shonha/EGR314SSH.github.io/docs/index.md

---
title: Welcome
---
## Brief Introduction
Hello, My name is Shon and this is my individual website for the stepper motor subsystem. I use SPI to communicate over a daisy chain network to recieve and send values over UART. My system has four main components: The Stepper Motor, Motor Driver, PIC Microcontroller, and the 3.3V Switching Regulator. The goal of the motor subsystem is to rotate the solar panel based off the message it recieves from the daisy chain network. In return, it will rotate the solar panel based on the direction of the sun so the panel can produce energy at its peak.

## Milestones
|Assignments|Dates|
|---|---|
|Block Diagram| 1/31|
|Component Selection & PIC Table|2/7|
|Schematic Design|2/21|
|Power Budget|2/21|
|External Design Review|2/24|
|BOM & Hardware Orders|2/28|
|Individual API Documentation|3/28|
|Subsystem PCB Design|4/4|
|Subsystem Hardware Verification|4/11|
|Software Implementation|4/23|
|Innovation Showcase|5/2|

[Team Website](https://egr314-2025-s-311.github.io/T311.github.io/)
