shonha/EGR314SSH.github.io/docs/componentschematic.md

---
title: Subsystem Schematic
---

Things to discuss
