shonha/EGR314SSH.github.io/docs/Resources.md

---
title: Resources
---

[Motor Subsystem MPLABX](https://github.com/shonha/EGR314SSH.github.io/blob/main/MPLAB/Team%20Verification.X.zip)

[Team Solar Tracker DXF Cutout](https://github.com/shonha/EGR314SSH.github.io/blob/main/MPLAB/EGR314_SolarTracka.dxf)
