shonha/EGR314SSH.github.io/images/314 BD V2.png

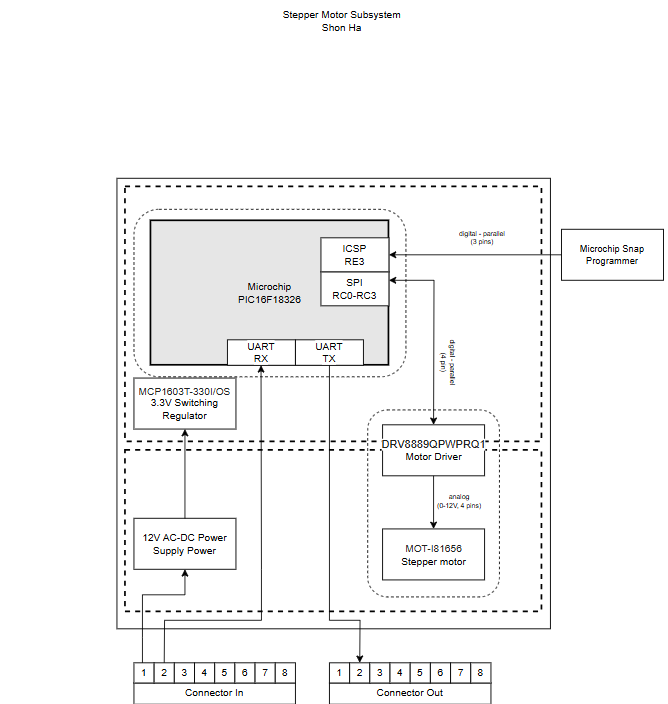
images/314 BD V2.png
