shonha/EGR314SSH.github.io/images/314 Motor Block DiagramV3.png

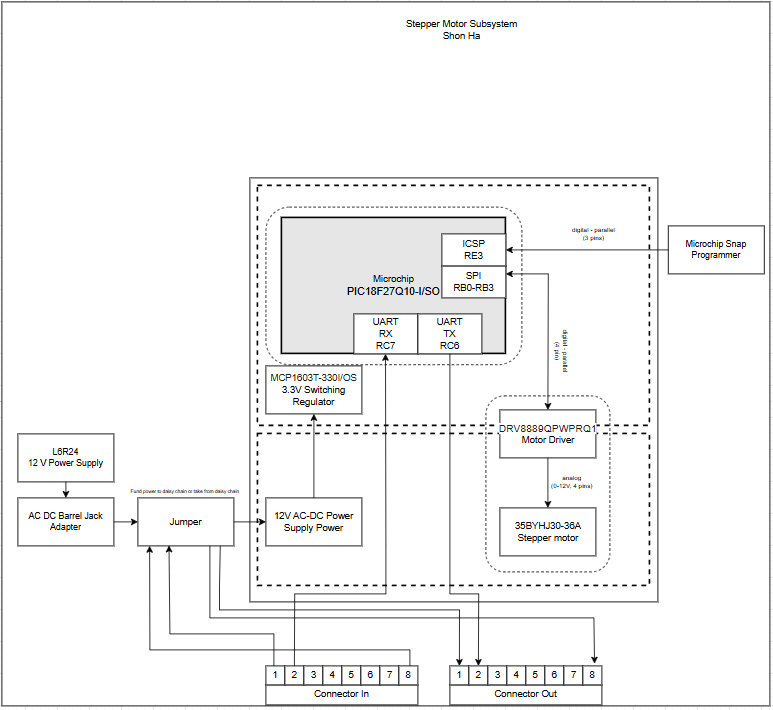
images/314 Motor Block DiagramV3.png
