shonha/EGR314SSH.github.io/images/BOMV2.png

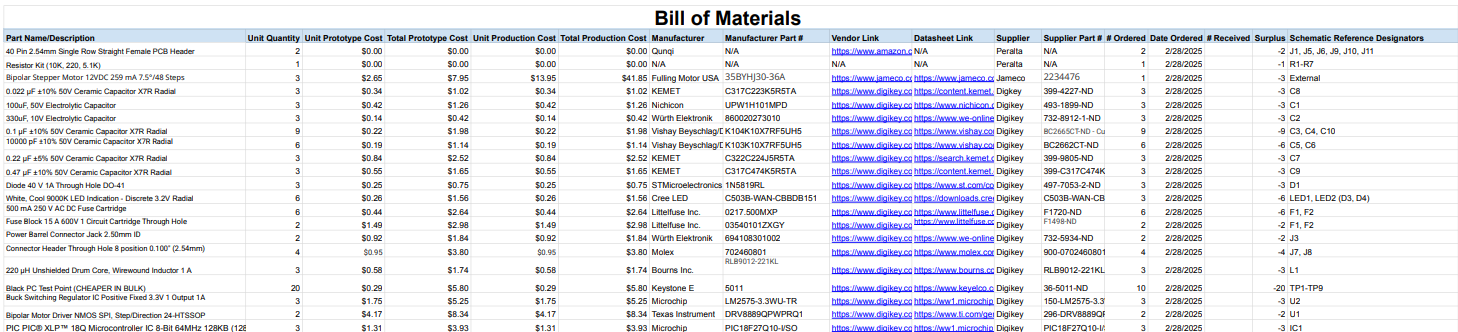
images/BOMV2.png
