shonha/EGR314SSH.github.io/images/cheapmotor.png

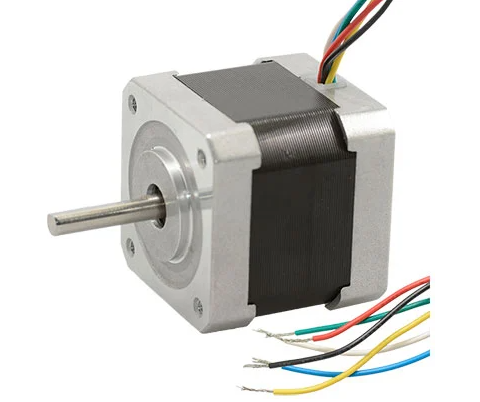
images/cheapmotor.png
