shonha/EGR314SSH.github.io/images/FINALPICLAY.png

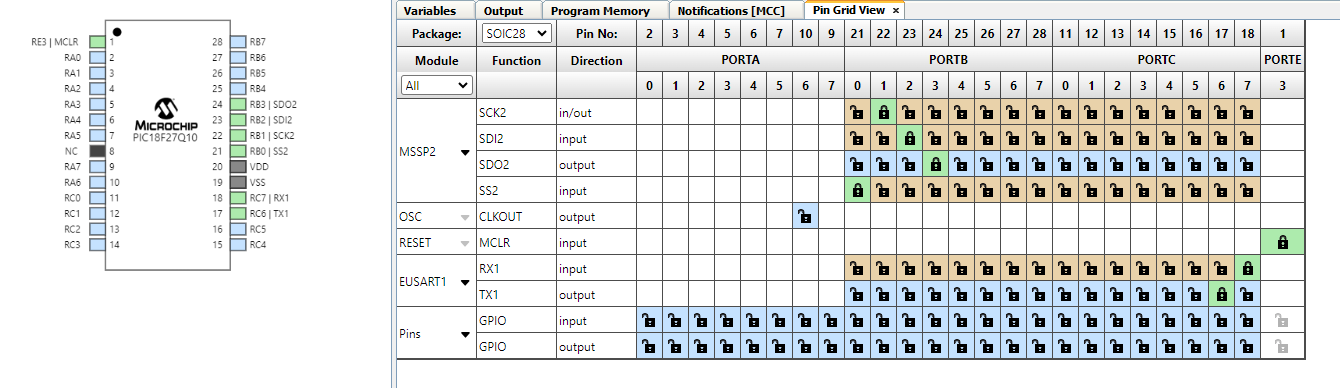
images/FINALPICLAY.png
