shonha/EGR314SSH.github.io/images/MCC CONFIG.png

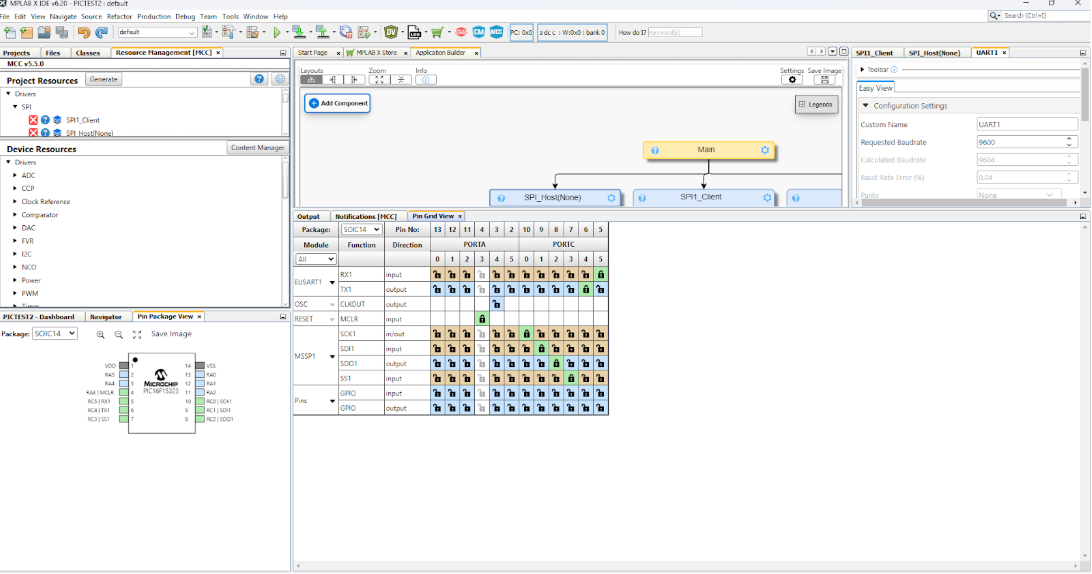
images/MCC CONFIG.png
