shonha/EGR314SSH.github.io/images/PICOPTION3.jpg

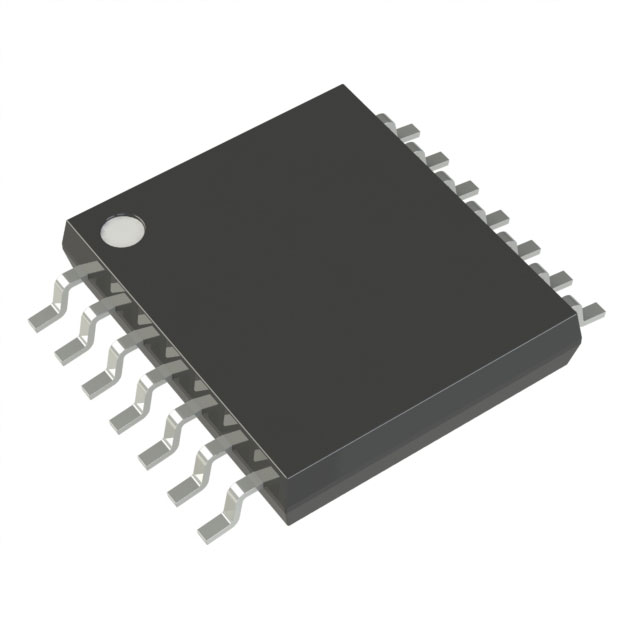
images/PICOPTION3.jpg
