shonha/EGR314SSH.github.io/images/PSOP3.jpg

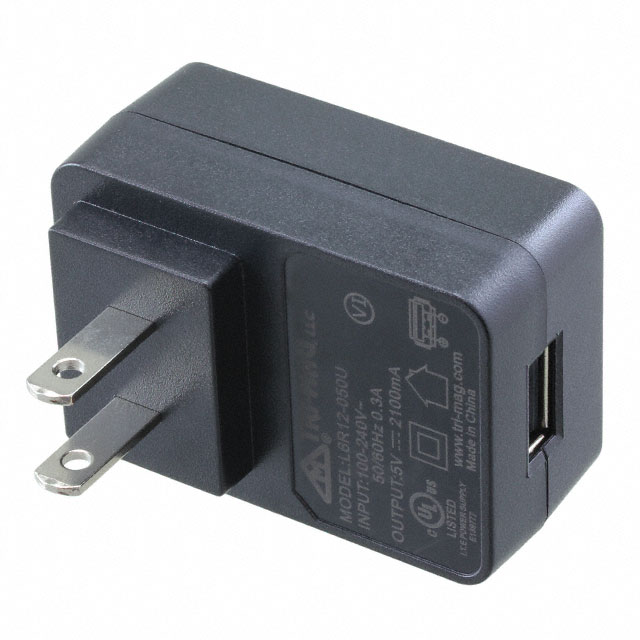
images/PSOP3.jpg
