shonha/EGR314SSH.github.io/images/Screenshot 2025-02-07 162354.png

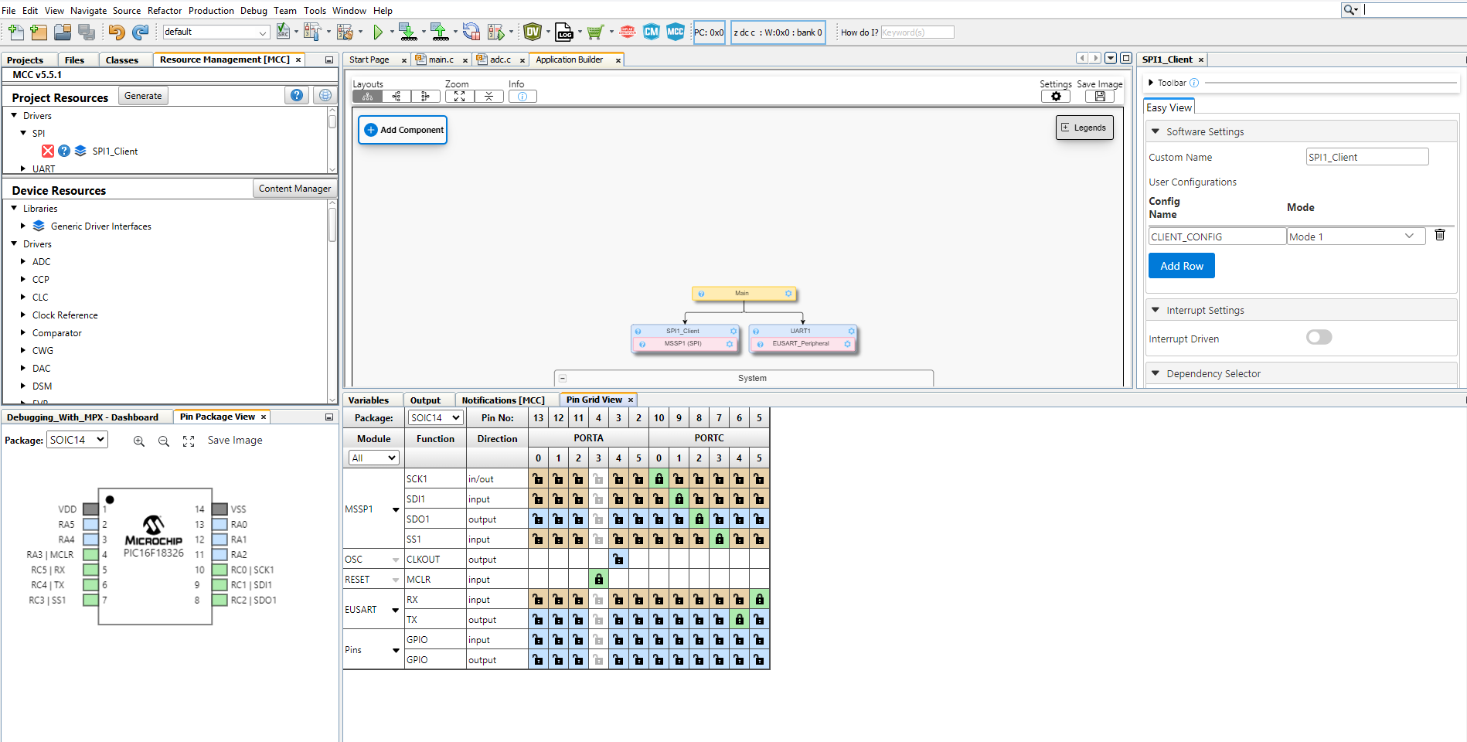
images/Screenshot 2025-02-07 162354.png
