shonha/EGR314SSH.github.io/images/SM4POSS.png

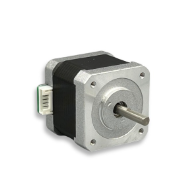
images/SM4POSS.png
