shonha/EGR314SSH.github.io/images/SMOP1.jpg

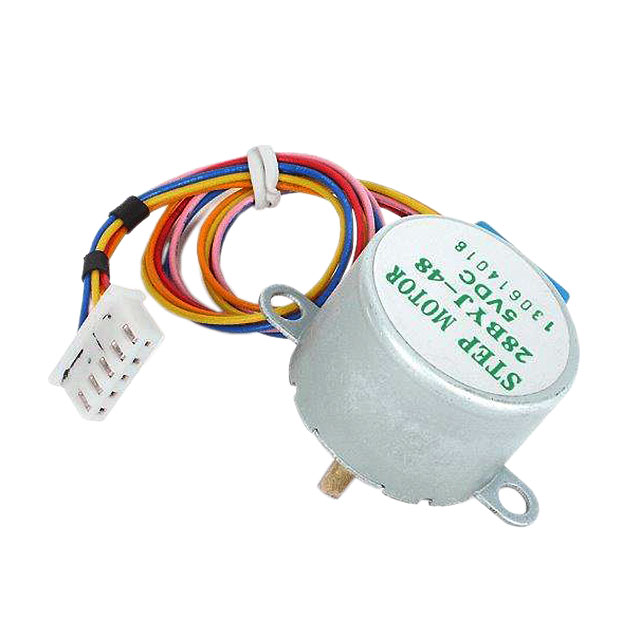
images/SMOP1.jpg
