shonha/EGR314SSH.github.io/images/SUBSYSTEM SCHEMATIC.png

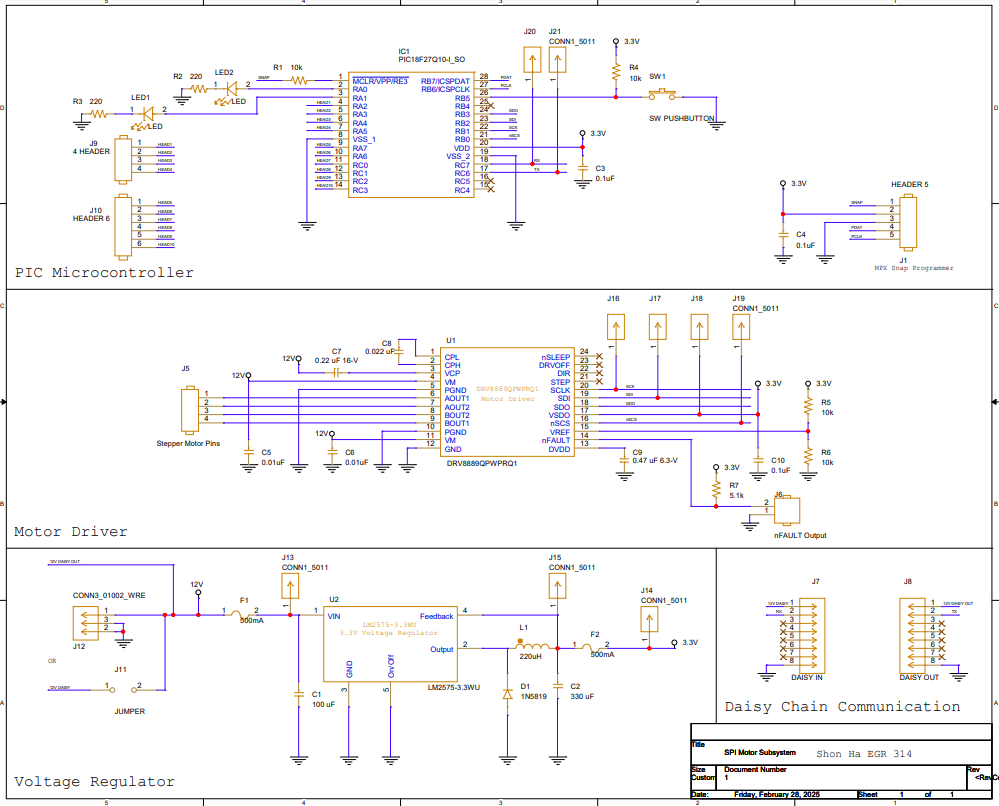
images/SUBSYSTEM SCHEMATIC.png
