shonha/EGR314SSH.github.io/images/Team Block Diagram-Page-3.drawio.png

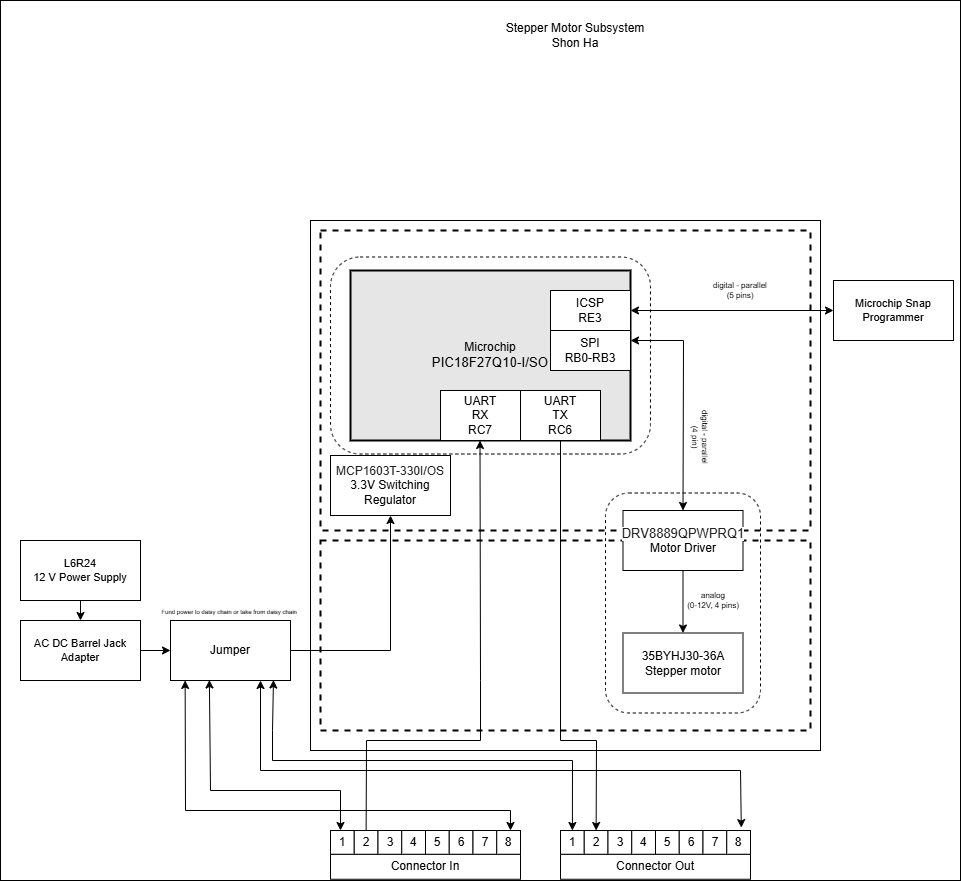
images/Team Block Diagram-Page-3.drawio.png
