shonha/EGR314SSH.github.io/images/VROP3.jpg

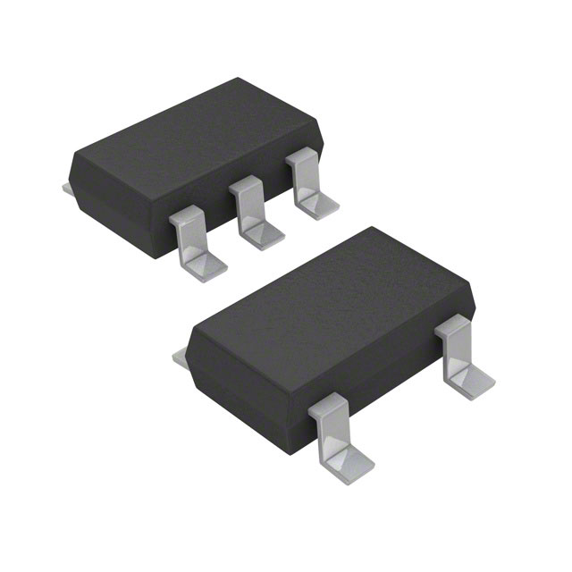
images/VROP3.jpg
