shonha/EGR314SSH.github.io/Documentation/EGR314 BOM.xlsx

Bill of Materials
Part Name/Description | Unit Quantity | Unit Prototype Cost | Total Prototype Cost | Unit Production Cost | Total Production Cost | Manufacturer | Manufacturer Part # | Vendor Link | Datasheet Link | Supplier | Supplier Part # | # Ordered | Date Ordered | # Received | Surplus | Schematic Reference Designators
40 Pin 2.54mm Single Row Straight Female PCB Header | 2 | $0.00 | $0.00 | $0.00 | $0.00 | Qunqi | N/A | https://www.amazon.com/Qunqi-2-54mm-Straight-Connector-Arduino/dp/B07CGGSDWF | N/A | Peralta | N/A | 2 | 2025-02-28 |  | -2 | J1, J5, J6, J9, J10, J11
Resistor Kit (10K, 220, 5.1K) | 1 | $0.00 | $0.00 | $0.00 | $0.00 | N/A | N/A | N/A | N/A | Peralta | N/A | 1 | 2025-02-28 |  | -1 | R1-R7
Bipolar Stepper Motor 12VDC 259 mA 7.5°/48 Steps | 3 | $2.65 | $7.95 | $13.95 | $41.85 | Fulling Motor USA | 35BYHJ30-36A | https://www.jameco.com/z/35BYHJ30-36A-Fulling-Motor-USA-Bipolar-Stepper-Motor-12VDC-259-mA-7-5-deg-48-Steps_2234476.html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 | https://www.jameco.com/Jameco/Products/ProdDS/2234476.pdf | Jameco | 2234476 | 1 | 2025-02-28 |  | -3 | External
CAP CER 0.022UF 50V C0G/NP0 0805 | 3 | $0.56 | $1.68 | $0.56 | $1.68 | KEMET | GCM21B5C1H223JA16L | https://www.digikey.com/en/products/detail/murata-electronics/GCM21B5C1H223JA16L/2039045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 | https://search.murata.co.jp/Ceramy/image/img/A01X/G101/ENG/GCJ188R71H104KA12-02B.pdf | Digkey | 490-5318-2-ND | 3 | 2025-02-28 |  | -3 | C8
100uF, 50V Electrolytic Capacitor | 3 | $0.71 | $2.13 | $0.71 | $2.13 | Nichicon | UUD1H101MNL1GS | https://www.digikey.com/en/products/detail/nichicon/UPW1H101MPD/589640?gclsrc=aw.ds&gad_source=1&gclsrc=aw.ds | https://www.nichicon.co.jp/english/series_items/catalog_pdf/e-uud.pdf | Digikey | 493-2306-2-ND | 3 | 2025-02-28 |  | -3 | C1
330uF, 10V Electrolytic Capacitor | 3 | $0.08 | $0.24 | $0.08 | $0.24 | Nichicon | UUD1A331MNL1GS | https://www.digikey.com/en/products/detail/w%C3%BCrth-elektronik/860020273010/5727147 | https://www.nichicon.co.jp/english/series_items/catalog_pdf/e-uud.pdf | Digikey | 493-2251-2-ND | 3 | 2025-02-28 |  | -3 | C2
0.1 µF ±10% 50V Ceramic Capacitor X7R Radial | 9 | $0.08 | $0.72 | $0.08 | $0.72 | YAGEO | CC0805KRX7R9BB104 | https://www.digikey.com/en/products/detail/yageo/CC0805KRX7R9BB104/302874 | https://www.yageo.com/upload/media/product/productsearch/datasheet/mlcc/UPY-GPHC_X7R_6.3V-to-250V_24.pdf | Digikey | 311-1140-2-ND | 9 | 2025-02-28 |  | -9 | C3, C4, C10
10000 pF ±10% 50V Ceramic Capacitor X7R Radial | 6 | $0.08 | $0.48 | $0.08 | $0.48 | KEMET | C0805C103K5RACTU | https://www.digikey.com/en/products/detail/kemet/C0805C103K5RACTU/411157 | https://search.kemet.com/download/datasheet/C0805C103K5RAC7800 | Digikey | 399-C0805C103K5RACTUTR-ND | 6 | 2025-02-28 |  | -6 | C5, C6
0.22 µF ±5% 50V Ceramic Capacitor X7R Radial | 3 | $0.10 | $0.30 | $0.10 | $0.30 | KEMET | C0805C224K5RACTU | https://www.digikey.com/en/products/detail/kemet/C0805C224K5RACTU/754753 | https://search.kemet.com/download/datasheet/C0805C224K5RAC7800 | Digikey | 399-C0805C224K5RACTUTR-ND | 3 | 2025-02-28 |  | -3 | C7
0.47 µF ±10% 50V Ceramic Capacitor X7R Radial | 3 | $0.22 | $0.66 | $0.22 | $0.66 | Murata Electronics | GRM21BR71H474KA88L | https://www.digikey.com/en/products/detail/murata-electronics/GRM21BR71H474KA88L/702592 | https://search.murata.co.jp/Ceramy/image/img/A01X/G101/ENG/GRM21BR71H474KA88-01.pdf | Digikey | 490-3328-2-ND | 3 | 2025-02-28 |  | -3 | C9
Diode 40 V 1A Through Hole DO-41 | 3 | $0.30 | $0.90 | $0.30 | $0.90 | Diodes Incorporated | 1N5819HWQ-7-F | https://www.digikey.com/en/products/detail/diodes-incorporated/1N5819HWQ-7-F/10294862 | https://www.diodes.com/assets/Datasheets/1N5819HWQ.pdf | Digikey | 31-1N5819HWQ-7-FTR-ND | 3 | 2025-02-28 |  | -3 | D1
White, Cool 9000K LED Indication - Discrete 3.2V Radial | 6 | $0.26 | $1.56 | $0.26 | $1.56 | Cree LED | C503B-WAN-CBBDB151 | https://www.digikey.com/en/products/detail/cree-led/C503B-WAN-CBBDB151/5824241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 | https://downloads.cree-led.com/files/ds/h/HB-C503B-WAN.pdf | Digikey | C503B-WAN-CBBDB151-ND | 3 | 2025-02-28 |  | -6 | LED1, LED2 (D3, D4)
500 mA 250 V AC DC Fuse Cartridge | 6 | $0.44 | $2.64 | $0.44 | $2.64 | Littelfuse Inc. | 0217.500MXP | https://www.digikey.com/en/products/detail/littelfuse-inc/0217.500MXP/777537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 | https://www.littelfuse.com/assetdocs/littelfuse-fuse-217-datasheet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 | Digikey | F1720-ND | 6 | 2025-02-28 |  | -6 | F1, F2
Fuse Block 15 A 600V 1 Circuit Cartridge Through Hole | 2 | $1.49 | $2.98 | $1.49 | $2.98 | Littelfuse Inc. | 03540101ZXGY | https://www.digikey.com/en/products/detail/littelfuse-inc/03540101ZXGY/553974 | https://www.littelfuse.com/assetdocs/littelfuse_fuse_block_354_datasheet.pdf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 | Digikey | F1498-ND | 2 | 2025-02-28 |  | -2 | F1, F2
Power Barrel Connector Jack 2.50mm ID | 2 | $0.92 | $1.84 | $0.92 | $1.84 | Würth Elektronik | 694108301002 | https://www.digikey.com/en/products/detail/w-rth-elektronik/694108301002/5047524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 | https://www.we-online.com/katalog/datasheet/6941xx301002.pdf | Digikey | 732-5934-ND | 2 | 2025-02-28 |  | -2 | J3
Connector Header Through Hole 8 position 0.100" (2.54mm) | 4 | $0.95 | $3.80 | $0.95 | $3.80 | Molex | 702460801 | https://www.digikey.com/en/products/detail/molex/0702460801/760165 | https://www.molex.com/en-us/products/part-detail/702460801?display=pdf | Digikey | 900-0702460801-ND | 4 | 2025-02-28 |  | -4 | J7, J8
220 µH Unshielded Drum Core, Wirewound Inductor 1 A | 3 | $1.35 | $4.05 | $1.35 | $4.05 | Murata Electronics | #B953AS-221M=P3 | https://www.digikey.com/en/products/detail/murata-electronics/B953AS-221M-P3/6205626 | https://www.murata.com/~/media/webrenewal/products/inductor/chip/tokoproducts/wirewoundferritetypeforpl/m_ds126c2.ashx | Digikey | 490-14109-2-ND | 3 | 2025-02-28 |  | -3 | L1
Black PC Test Point (CHEAPER IN BULK) | 20 | $0.29 | $5.80 | $0.29 | $5.80 | Keystone E | 5011 | https://www.digikey.com/en/products/detail/keystone-electronics/5011/255333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 | https://www.keyelco.com/userAssets/file/M65p56.pdf | Digikey | 36-5011-ND | 10 | 2025-02-28 |  | -20 | TP1-TP9
Buck Switching Regulator IC Positive Fixed 3.3V 1 Output 1A | 3 | $1.75 | $5.25 | $1.75 | $5.25 | Microchip | LM2575-3.3WU-TR | https://www.digikey.com/en/products/detail/microchip-technology/LM2575-3.3WU-TR/16679441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 | https://ww1.microchip.com/downloads/en/DeviceDoc/lm2575.pdf | Digikey | 150-LM2575-3.3WU-TRCT-ND | 3 | 2025-02-28 |  | -3 | U2
Bipolar Motor Driver NMOS SPI, Step/Direction 24-HTSSOP | 2 | $4.17 | $8.34 | $4.17 | $8.34 | Texas Instrument | DRV8889QPWPRQ1 | https://www.digikey.com/en/products/detail/texas-instruments/DRV8889QPWPRQ1/11615769 | https://www.ti.com/general/docs/suppproductinfo.tsp?distId=10 | Digikey | 296-DRV8889QPWPRQ1CT-ND | 2 | 2025-02-28 |  | -2 | U1
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
 |  |  |  |  |  |  |  |  |  |  |  |  |  |  | 0
 |  |  |  |  |  |  |  |  |  |  |  |  |  |  | 0
 |  |  |  |  |  |  |  |  |  |  |  |  |  |  | 0
 |  |  |  |  |  |  |  |  |  |  |  |  |  |  | 0
 |  |  |  |  |  |  |  |  |  |  |  |  |  |  | 0
 |  |  |  |  |  |  |  |  |  |  |  |  |  |  | 0
