shonha/EGR314SSH.github.io/Documentation/EGR 314 Digikey.xlsx

Sheet: Purchase Request
Course/Capstone/eProject/FURI Purchase Request
Name of Class or Project: EGR 304/314 |  |  |  | Vendor (one vendor per form): Digi-key
Date | Faculty/PI Contact | Student Name & Email | eProject? Capstone Project? Course Project? |  |  | eProject Industry Sponsor (if applicable)
2025-03-02 | Jordan / Kelley / Nichols | shon ha ssha5@asu.edu | Yes / No Yes / No Yes / No |  |  | n/a
A purchasing card is available to check out for local purchases or you may come to Sutton 101 and order your supplies, using this purchasing card.
Qty | Item # or Quote # | Direct Website Link to Product |  | General Description of Item |  | Business Purpose/Benefit for the Purchase | Unit Price | Line Total
6 | 12345ABCDE | www.thisistheplace.com/12345ABCDE (SAMPLE: PLEASE START ON NEXT LINE) |  | safety goggles |  | protect student/instructor eyes while working on project; benefit to the University of reducing number of accidents in the lab | $3.490 | $20.94
3 | GCM21B5C1H223JA16L | https://www.digikey.com/en/products/detail/murata-electronics/GCM21B5C1H223JA16L/2039045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 |  | CAP CER 0.022UF 50V C0G/NP0 0805 |  | current limiting capacitor/datasheet requirement | $0.26 | $0.78
3 | UUD1H101MNL1GS | https://www.digikey.com/en/products/detail/nichicon/UUD1H101MNL1GS/590047 |  | 100uF, 50V Electrolytic Capacitor |  | current limiting capacitor/datasheet requirement | $0.56 | $1.68
3 | UUD1A331MNL1GS | https://www.digikey.com/en/products/detail/nichicon/UUD1A331MNL1GS/589992 |  | 330uF, 10V Electrolytic Capacitor |  | current limiting capacitor/datasheet requirement | $0.71 | $2.13
9 | CC0805KRX7R9BB104 | https://www.digikey.com/en/products/detail/yageo/CC0805KRX7R9BB104/302874 |  | 0.1 µF ±10% 50V Ceramic Capacitor X7R Radial |  | current limiting capacitor/datasheet requirement | $0.08 | $0.72
6 | C0805C103K5RACTU | https://www.digikey.com/en/products/detail/kemet/C0805C103K5RACTU/411157 |  | 10000 pF ±10% 50V Ceramic Capacitor X7R Radial |  | current limiting capacitor/datasheet requirement | $0.19 | $1.14
3 | C0805C224K5RACTU | https://www.digikey.com/en/products/detail/kemet/C0805C224K5RACTU/754753 |  | 0.22 µF ±5% 50V Ceramic Capacitor X7R Radial |  | current limiting capacitor/datasheet requirement | $0.10 | $0.30
3 | GRM21BR71H474KA88L | https://www.digikey.com/en/products/detail/murata-electronics/GRM21BR71H474KA88L/702592 |  | 0.47 µF ±10% 50V Ceramic Capacitor X7R Radial |  | current limiting capacitor/datasheet requirement | $0.19 | $0.57
3 | 1N5819HWQ-7-F | https://www.digikey.com/en/products/detail/diodes-incorporated/1N5819HWQ-7-F/10294862 |  | Diode 40 V 1A Surface Mount SOD-123 |  | datasheet requirement | $0.30 | $0.90
6 | C503B-WAN-CBBDB151-ND | https://www.digikey.com/en/products/detail/cree-led/C503B-WAN-CBBDB151/5824241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 |  | White, Cool 9000K LED Indication - Discrete 3.2V Radial |  | debugging led | $0.26 | $1.56
6 | F1720-ND | https://www.digikey.com/en/products/detail/littelfuse-inc/0217.500MXP/777537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 |  | 500 mA 250 V AC DC Fuse Cartridge |  | ensure no short circuitting | $0.44 | $2.64
2 | F1498-ND | https://www.digikey.com/en/products/detail/littelfuse-inc/03540101ZXGY/553974 |  | Fuse Block 15 A 600V 1 Circuit Cartridge Through Hole |  | hold the fuse | $1.49 | $2.98
2 | 732-5934-ND | https://www.digikey.com/en/products/detail/w-rth-elektronik/694108301002/5047524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 |  | Power Barrel Connector Jack 2.50mm ID |  | get power from power supply | $0.92 | $1.84
4 | 0702460801 | https://www.digikey.com/en/products/detail/molex/0702460801/760165 |  | Connector Header Through Hole 8 position 0.100" (2.54mm) |  | connect to daisy chain | $0.95 | $3.80
3 | #B953AS-221M=P3 | https://www.digikey.com/en/products/detail/murata-electronics/B953AS-221M-P3/6205626 |  | 220 µH Unshielded Drum Core, Wirewound Inductor 1 A |  | internal component for electrical use | $1.35 | $4.05
20 | 36-5011-ND | https://www.digikey.com/en/products/detail/keystone-electronics/5011/255333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 |  | Black PC Test Point (CHEAPER IN BULK) |  | debugging | $0.29 | $5.80
3 | 150-LM2575-3.3WU-TRCT-ND | https://www.digikey.com/en/products/detail/microchip-technology/LM2575-3.3WU-TR/16679441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 |  | Buck Switching Regulator IC Positive Fixed 3.3V 1 Output 1A |  | regulate voltage for internals | $1.75 | $5.25
3 | PIC18F27Q10-I/SO | https://www.digikey.com/en/products/detail/microchip-technology/PIC18F27Q10-I-SO/10064343 |  | PIC PIC® XLP™ 18Q Microcontroller IC 8-Bit 64MHz 128KB (128K x 8) FLASH 28-SOIC |  | PIC microcontroller to code the system | $1.31 | $3.93
3 | 296-DRV8889QPWPRQ1CT-ND | https://www.digikey.com/en/products/detail/texas-instruments/DRV8889QPWPRQ1/11615769 |  | Bipolar Motor Driver NMOS SPI, Step/Direction 24-HTSSOP |  | control motor through spi | $4.17 | $12.51
 |  |  |  |  |  |  | Sub-Total | $52.58
Chair or PI Approval: |  |  |  |  | Date: |  | Tax
 |  |  |  |  |  |  | Shipping
 |  |  |  |  |  |  | Grand Total | $52.58
Business Purpose/Public Benefit: (Click on yellow line. Next, select an option on the drop-down arrow on the right of the box)
Lab / Classroom / Medical Supplies
Business Purpose: A commodity needed for experimentation, observation or practice in a field of study (such as goggles, aprons, test tubes, flasks, and plates etc).
Public Benefit: Supplies are used in day-to-day lab operations. ASU benefits from this expense as the supplies purchased allow departmental lab employees and students to perform general lab duties, projects, and research activities.
Student: Forward completed form to Instructor/Project Mentor for approval
Mentor/Faculty: Forward form with email indicating your approval to PolyBizz@asu.edu for processing
 | 1. A purchasing card is available to check out for local purchases. 2. You may come to Sutton 101 and place your order online.
SECTION BELOW IS FOR OFFICE USE ONLY
ORDER PLACED BY / DATE: |  |  |  |  |  | B.O. NOTIFIED BY / DATE:
ORDER RECEIVED BY / DATE: |  |  |  |  |  | STUDENT / INSTRUCTOR NOTIFIED BY / DATE:
COST CENTER + PROGRAM/GIFT TO CHARGE:

Sheet: Sheet1
Category |  |  | Reimbursement Justification
Audiovisual Electronic Equipment and Accessories (Non-Capital) | Business Purpose: Non-capital Audiovisual devices, equipment, or accessories purchased to facilitate The Polytechnic School business and operations. | Public Benefit: ASU benefits from this expense as the items purchased allow faculty, staff, and students to conduct video conferencing and/or meetings and discussions with a technological aide to further Polytechnic School business, operations, and maintain partnerships and collaboration with off-campus organizations. | Purchase Made Outside Business Hours | The items or services purchased were made outside of business hours, most often for immediate use outside of business hours. It was necessary for the Requestor to make this purchase, as the need for it was imperative.
Audiovisual R/M Supplies | Business Purpose: Audiovisual commodity items purchased to maintain Audiovisual equipment. | Public Benefit: ASU benefits from this expense as the items purchased allow staff & students to utilize functional Audiovisual equipment in order to further classroom, lab, and research project efforts. | Items/Service Needed While Off Campus | The items or services purchased were needed while the Requestor was doing ASU business off campus and/or in travel status. The purchase was necessary, and standard ASU purchasing methods were unavailable at the time.
Books / Reference Materials | Business Purpose: A set of printed sheets bound together into a volume, printed material, or a digital equivalent that directs a reader or researcher to specific sources of information. | Public Benefit: Books/Reference Materials purchased to assist an instructor with a course. ASU benefits from this expense as the textbook or reference materials purchased allow course instructor to facilitate students in meeting requirements of project and class activities. | Standard ASU Purchasing Methods Not Available | Due to either a system outage/limitation or a personnel issue, the standard ASU Purchasing methods were unavailable at the time that the Requestor needed this purchase to be made.
Credit – Returned Items | Business Purpose: Credit received for returned items. Problem occurred with product, or the product was not received in a timely manner. | Public Benefit: ASU benefits from this credit as the funds can be used to purchase a replacement item, for other project needs, research activities, or operational needs.
Document Printing | Business Purpose: Printing of documents, journals, or other materials for current and future projects. | Public Benefit: This expense ensures that ASU employees and students have proper information when working on research, projects, or operational duties.
Electronic Devices – Computers | Business Purpose: Personal computers and accessories having a life expectancy of less than one year or a unit cost of less than $5,000 purchased to equip an office or lab. | Public Benefit: Personal computers are used to equip faculty, staff, and students with the proper tools to conduct university business and daily activities. ASU benefits from this expense as the computers allow departmental employees and students to perform daily duties.
Electronic Devices – Non Capital | Business Purpose: Non-capital Electronic devices purchased for employees and students to perform testing and complete project requirements. | Public Benefit: ASU benefits from this expense as electronic devices allow faculty, staff, and students to complete projects and to participate in research in the field and then import it into classroom.
Electronic Equipment – Computer Hardware Supplies | Business Purpose: Keyboard, mouse, flash drives, memory, CD and DVD disks, etc purchased to be used by all departmental employees. | Public Benefit: Computer Hardware supplies are used in day-to-day operations. ASU benefits from this expense as the supplies purchased allow departmental employees to perform general job duties, projects, and research.
Electronic Equipment / Accessories | Business Purpose: Non-capital equipment/accessories purchased for employees and students to use in classroom. | Public Benefit: ASU benefits from this expense as the equipment/accessories purchased allow employees to perform daily duties, complete research, and assist students in classroom.
Equipment Repair / Maintenance Materials | Business Purpose: Materials purchased to maintain and run existing equipment in the lab. | Public Benefit: Equipment is used in day-to-day lab operations. ASU benefits from this expense as the supplies purchased allow departmental lab employees and students to perform general lab duties, projects, class activities, and research.
Equipment Repair / Maintenance Service | Business Purpose: Service to repair and/or to maintain existing equipment in the lab in order to allow uninterrupted operations. | Public Benefit: Equipment is used in daily lab operations. ASU benefits from this expense as the equipment repaired and/or maintained allows departmental lab employees and students to perform general lab duties, projects, class activities, and research.
Field Supplies | Business Purpose: A commodity needed to perform field work for research or instructional purposes. | Public Benefit: Field supplies are used in day-to-day field work operations. ASU benefits from this expense as the supplies purchased allow departments to benefit from the research or instructional field work that is produced as a result.
Furniture/Other Equipment (Non-Capital) | Business Purpose: Furniture and other similar non-capital equipment purchased to furnish staff/faculty offices. | Public Benefit: ASU benefits from this expense as the furniture and other similar equipment allows departmental employees to perform daily operations and creates a welcoming and functional environment that is conducive to collaboration and efficiency.
Lab – Chemical Supplies | Business Purpose: Chemicals and similar materials purchased to maintain and/or conduct both daily lab operations as well as current and new research in the lab. | Public Benefit: ASU benefits from this expense as the chemical supplies purchased allow departmental lab employees and students to perform general lab duties, projects, and research activities. Functional labs increase academic and operational success for students, faculty, and staff.
Lab / Classroom / Medical Supplies | Business Purpose: A commodity needed for experimentation, observation or practice in a field of study (such as goggles, aprons, test tubes, flasks, and plates etc). | Public Benefit: Supplies are used in day-to-day lab operations. ASU benefits from this expense as the supplies purchased allow departmental lab employees and students to perform general lab duties, projects, and research activities.
Non-Capital Equipment – Lab / Scientific / Engineering | Business Purpose: Equipment and accessories having a life expectancy of less than one year or a unit cost of less than $5,000 purchased to equip an ASU operational/research laboratory. | Public Benefit: Lab equipment is used to equip departmental labs for employee and student use. ASU benefits from this expense as the equipment purchased allows departmental lab employees and students to perform daily duties that require lab use and/on specific equipment.
Office Operations – Service Requests | Business Purpose: Services to replace, repair, deconstruct, remove, install, and/or otherwise maintain equipment, furniture, walls, space, and/or anything else in the office that can be serviced. | Public Benefit: Office equipment, furniture, walls, and space (etc...) are used in daily office operations. ASU benefits from this expense as the service/maintenance provided allows departmental personnel and students to perform general office duties, projects, activities, and research.
Office Supplies | Business Purpose: Pencils, pens, paper, toner, highlighters and miscellaneous supplies purchased to stock the departmental supply cabinet, used by all departmental employees. | Public Benefit: Supplies are used in day-to-day departmental operations. ASU benefits from this expense as the supplies purchased allow departmental employees to perform general job duties.
Other Services – Miscellaneous | Business Purpose: Payments made for other services not specifically categorized. These expenses benefit daily business, classroom, and research operations. | Public Benefit: This expense benefits ASU in that the services purchased will benefit and/or facilitate classroom, research, and operational needs.
Outgoing Freight | Business Purpose: Outgoing freight to an approved vendor for the shipment of materials, supplies, and/or equipment needed for the completion of a research, student projects, and day-to-day lab and office duties. | Public Benefit: Shipping is necessary in order to deliver materials, supplies, and/or equipment in a timely manner in order to effectively support a project. ASU benefits from this expense as the freight received allows departmental/lab employees and students to perform general lab duties, projects, and class activities.
Parking – ASU Campus Permits | Business Purpose: Green or Red Parking Passes to be used by ASU employees or invited speakers/guests to attend meetings, classes, and functions at the various ASU Campuses. | Public Benefit: ASU benefits from this expense as parking passes ease the burden of parking on campus and assure timely arrival to scheduled meetings and functions. The benefit that ASU Campus Parking Passes provide encourages more frequent meeting and collaboration.
Printing Services | Business Purpose: Printing of any other miscellaneous materials for projects, departmental needs, or Polytechnic School needs. | Public Benefit: This expense ensures that ASU employees and students have proper information when working on research, projects, or operational duties.
Project Supplies | Business Purpose: Materials and supplies purchased to complete a designated project by students and/or departmental employees. | Public Benefit: ASU benefits from this expense as the supplies purchased allow departmental lab employees and students to meet the requirements of their designated project and class activities. The successful completion of project and class activities furthers ASU’s agenda as an exceptional academic institution.
Repair and Maintenance Materials and Supplies | Business Purpose: Commodity items purchased to restore and/or maintain grounds, infrastructure, and utility systems, buildings, or equipment. | Public Benefit: Repair and Maintenance materials and supplies benefit ASU as the materials purchased allow departmental employees to perform daily duties and maintain University property and equipment.
Software and Computing Supplies | Business Purpose: Non-capital equipment or software purchased to equip faculty and staff offices for departmental use. This expense allows for efficient daily lab, business, customer service, and research operations. | Public Benefit: ASU benefits from this expense as the supplies and software purchased allow departmental employees to perform daily general duties, prepare for class instruction and class projects, and complete office duties and projects.
Subscriptions | Business Purpose: Subscriptions allow students, faculty, and staff access to the various services that benefit student and staff success, and that are necessary to meet the needs of projects and research. | Public Benefit: Subscriptions are used in day-to-day operations. ASU benefits from this expense as access to the various subscription services allow students, faculty, and staff to successfully complete projects, research, and class activities.
USPS Charges | Business Purpose: Expenses to send out by priority mail that need to be received very quickly in order to maintain continuity of ASU business. | Public Benefit: This expense will benefit ASU through increased exposure, timely responses, and will allow for new opportunities for The Polytechnic School.
Vehicle R/M Supplies and Services | Business Purpose: Services performed or commodity items purchased to equip, restore, and/or maintain ASU owned vehicles that serve The Polytechnic School and ASU purposes. | Public Benefit: ASU benefits from this expense as R/M services and supplies/materials purchased allow departmental employees to maintain these vehicles and thus perform daily duties that require vehicle use.
