shonha/EGR314SSH.github.io/images/BOM .png

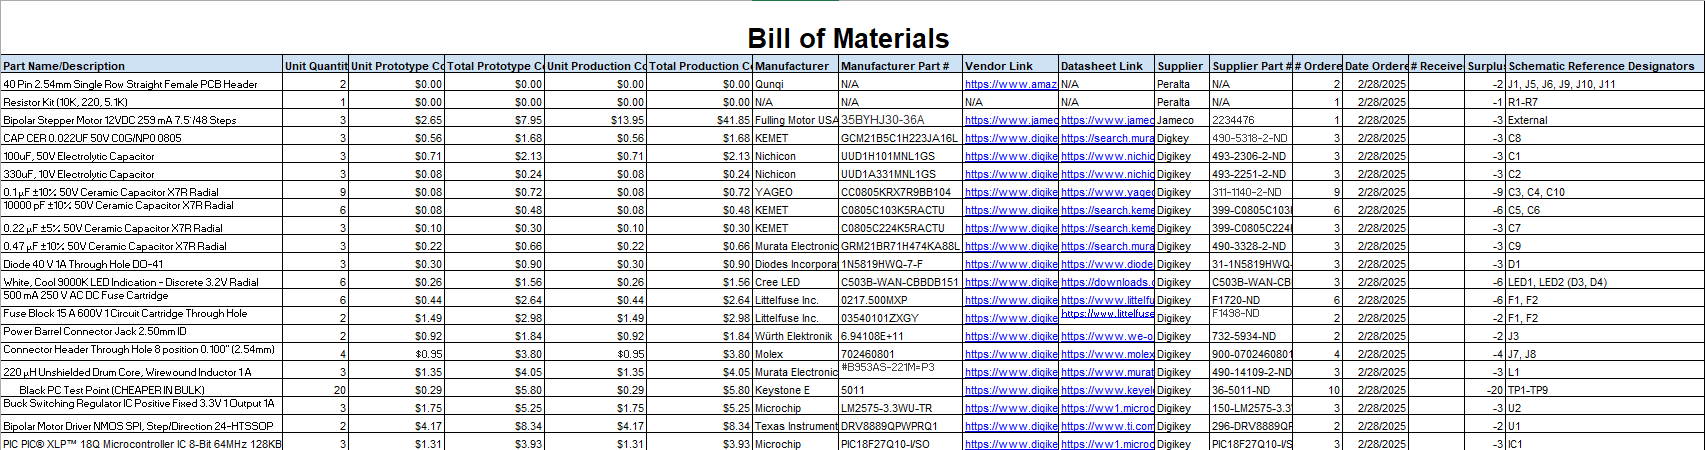
images/BOM .png
