shonha/EGR314SSH.github.io/MPLAB/EGR314_SolarTracka.dxf

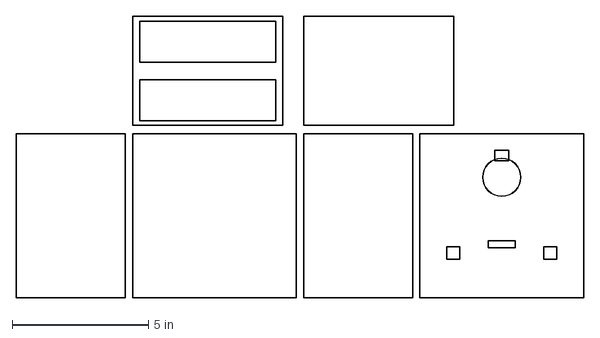
[picture p40: CAD file, 2025-05-03]
MPLAB/EGR314_SolarTracka.dxf
20.8 x 10.3 in
