shonha/EGR314SSH.github.io/Documentation/EGR314 BOM.xlsx - Google Sheets.pdf

# Bill of Materials

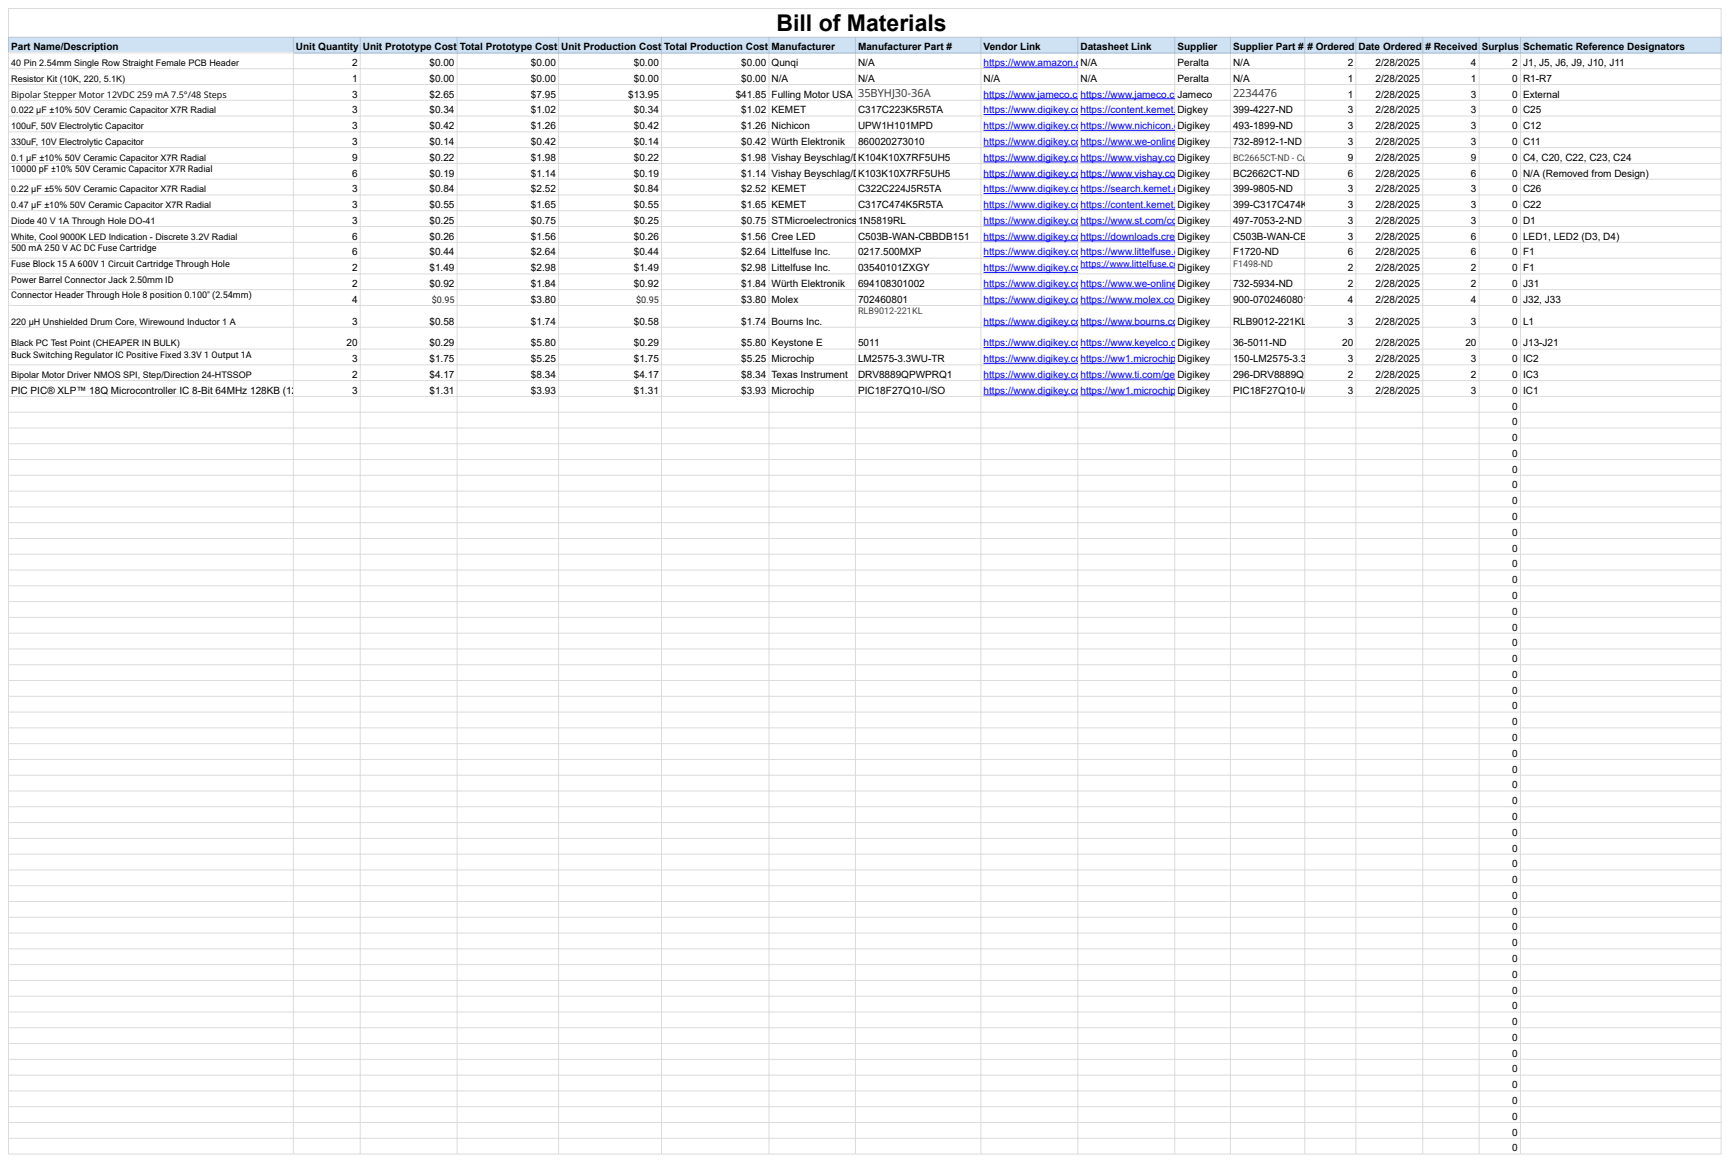
[picture p41: page 1]

40 Pin 2.54mm Single Row Straight Female PCB Header
Resistor Kit (10K, 220, 5.1K)

https://www.jameco.c
https://www.digikey.cohttps://content.kemet.
https://www.digikey.cohttps://www.nichicon.c
https://www.digikey.cohttps://www.we-online
https://www.digikey.cohttps://www.vishay.co
https://www.digikey.cohttps://search.kemet.c
https://www.digikey.cohttps://www.st.com/co
https://www.digikey.cohttps://downloads.cre
https://www.digikey.cohttps://www.littelfuse.c
https://www.digikey.co
https://www.digikey.cohttps://www.molex.co

0.022 µF ±10% 50V Ceramic Capacitor X7R Radial
100uF, 50V Electrolytic Capacitor
330uF, 10V Electrolytic Capacitor
0.1 µF ±10% 50V Ceramic Capacitor X7R Radial
10000 pF ±10% 50V Ceramic Capacitor X7R Radial

0.22 µF ±5% 50V Ceramic Capacitor X7R Radial
0.47 µF ±10% 50V Ceramic Capacitor X7R Radial
Diode 40 V 1A Through Hole DO-41
White, Cool 9000K LED Indication - Discrete 3.2V Radial
500 mA 250 V AC DC Fuse Cartridge
Fuse Block 15 A 600V 1 Circuit Cartridge Through Hole
Power Barrel Connector Jack 2.50mm ID
Connector Header Through Hole 8 position 0.100" (2.54mm)

https://www.littelfuse.co

220 µH Unshielded Drum Core, Wirewound Inductor 1 A

https://www.digikey.cohttps://www.bourns.co

Black PC Test Point (CHEAPER IN BULK)
Buck Switching Regulator IC Positive Fixed 3.3V 1 Output 1A

https://www.digikey.cohttps://www.keyelco.c
https://www.digikey.cohttps://ww1.microchip
https://www.digikey.cohttps://www.ti.com/ge

Bipolar Motor Driver NMOS SPI, Step/Direction 24-HTSSOP

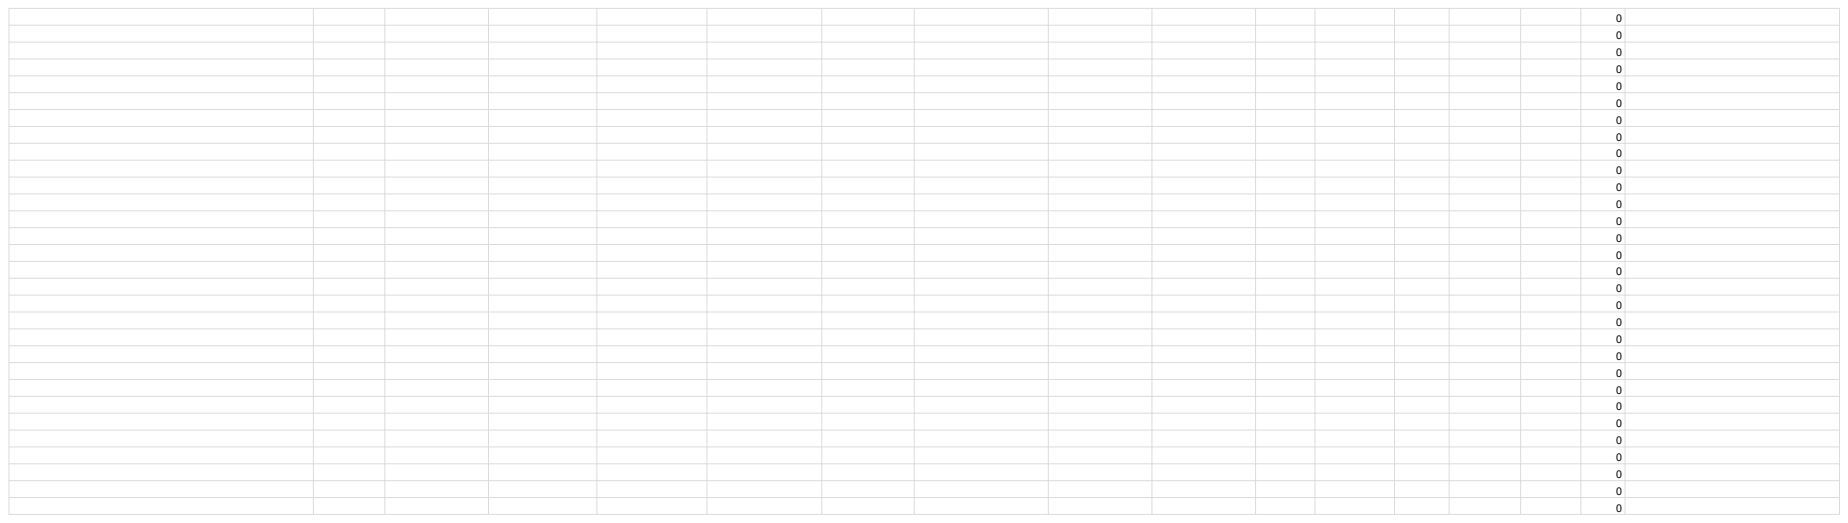
[picture p42: page 2]
