shonha/EGR314SSH.github.io/Cadence/EGR314PDF.pdf

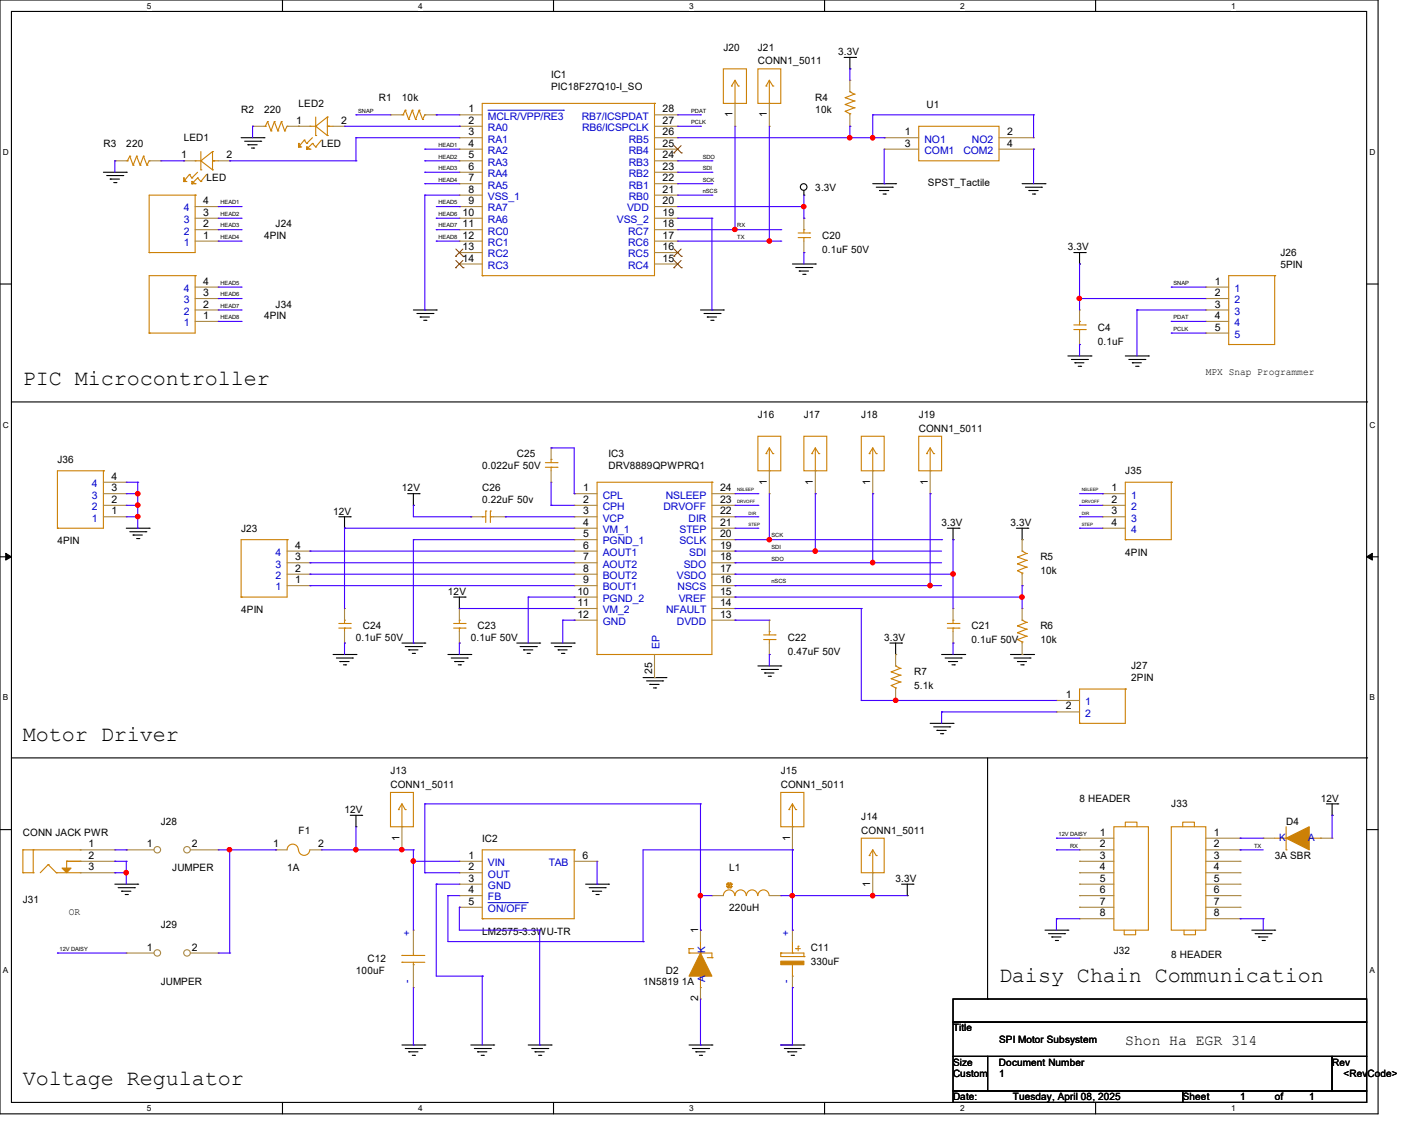
[picture p43: page 1]

J20 | J21 CONN1_5011

MPX Snap Programmer PIC Microcontroller

3 | SDO
1 | nSCS
