shonha/EGR314SSH.github.io/Cadence/EGR314PDFPCB.pdf

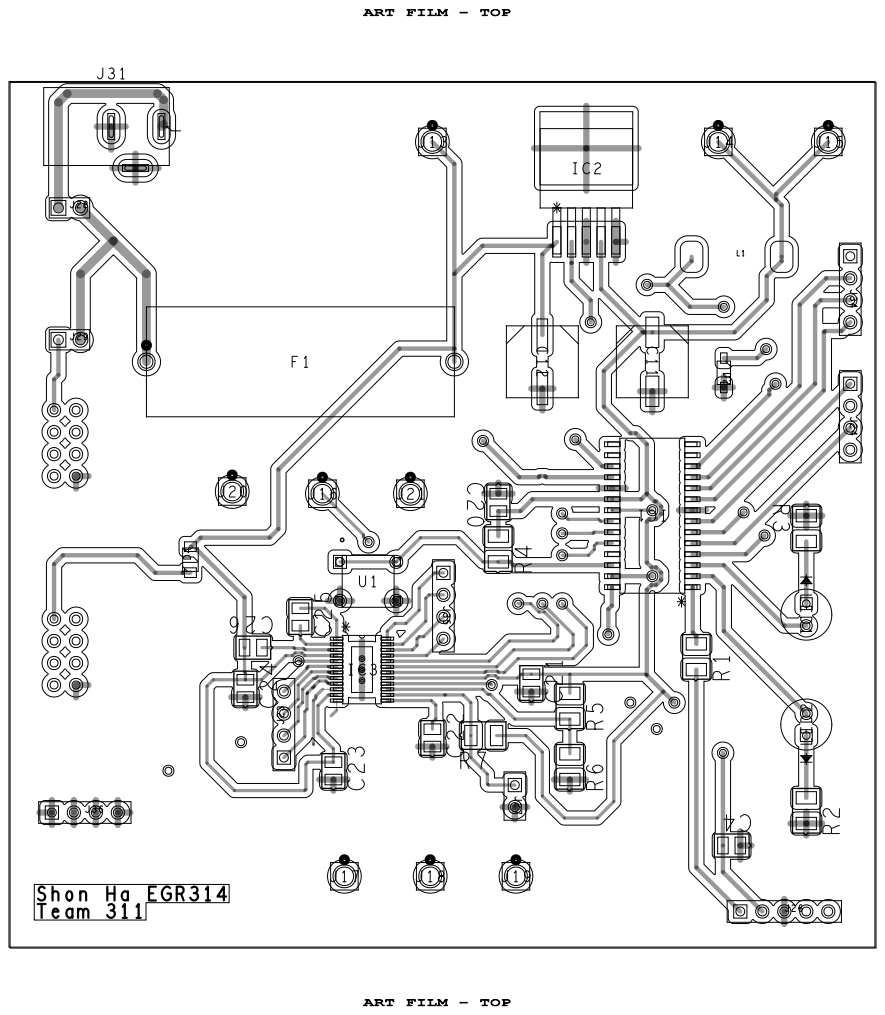
[picture p44: page 1]

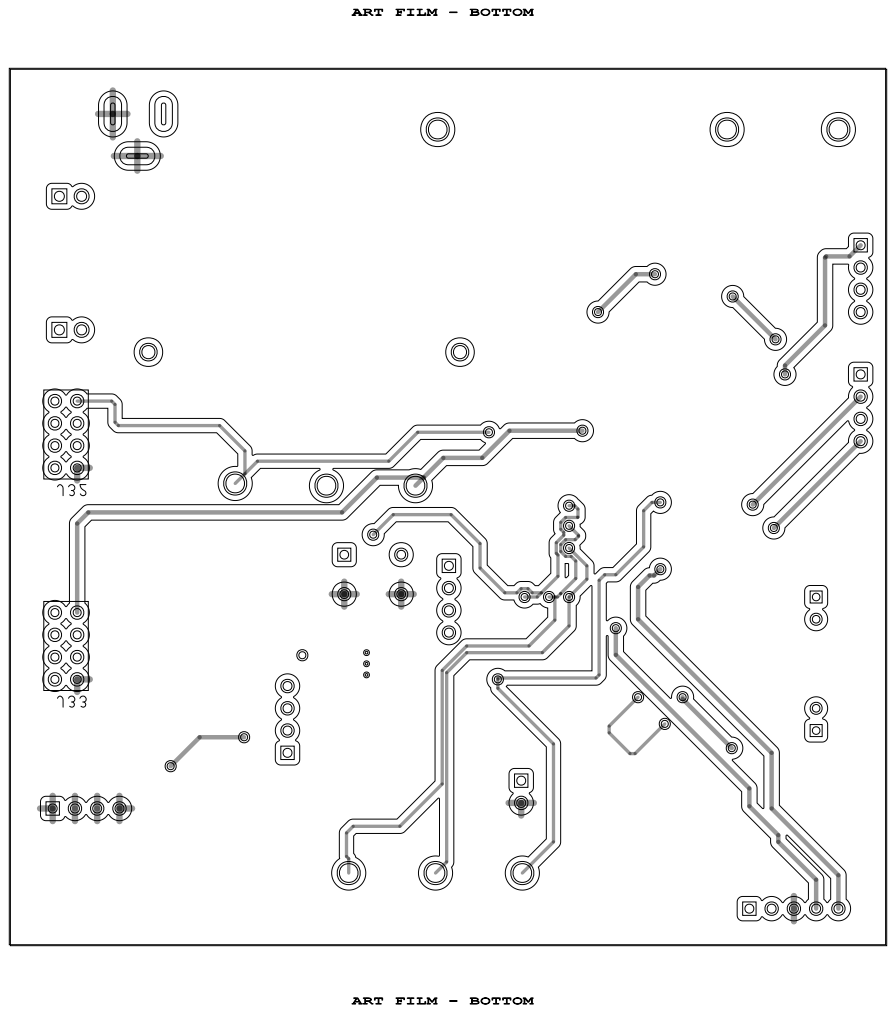
[picture p45: page 2]

ART FILM - BOTTOM
