shonha/EGR314SSH.github.io/(commit log)

2025-02-16 Rename Screenshot 2025-02-15 175257.png to 314 Motor Block Diagram V2.png
2025-02-18 Create Power Budget.md
2025-02-21 Update Power Budget.md
2025-02-21 Update and rename componentschematic.md to Schematic Design.md
2025-02-22 Update Schematic Design.md
